AstuteFlamez/robocar/phase_1_powertrain/bom.md

# Phase 1 — Bill of Materials

> Parts **introduced or first used** in Phase 1 (the powertrain + the motor side of the power tree). This is a slice of the master list — see [`../_engineering/products_to_buy.md`](../_engineering/products_to_buy.md) for the full, union-of-all-phases BOM with cost summary. Prices are ballpark USD, early 2026. "Why" gives the *electrical* reason the part exists.

## Core: brain + motor drivers

| Item | Qty | ~$ | Why (electrical reason) | Link | Status |
|---|---|---|---|---|---|
| Raspberry Pi Pico 2W (RP2350) | 1 | — | Real-time co-processor; sources four 20 kHz PWM channels + direction bits. 3V3(OUT) (≤300 mA) feeds the driver logic. Powered from laptop USB this phase. | (have) | already have (kit/shelf) |
| Pololu **TB6612FNG** dual H-bridge (#713) | 2 | $9.90 ($11.45) | 1.2 A continuous / **3.2 A peak per channel** → real headroom over the 310's 1.4 A stall; one motor/channel = 4 independent wheels for Mecanum. Replaces the DRV8833 (whose ~1.2–1.3 A sustainable limit sits on the stall knee). | https://www.pololu.com/product/713 | **buy** |
| "310" metal-gear motors w/ Hall encoders (JGA27-310 / MD310Z20) | 4 | — | The drive wheels: 7.4 V, ≤0.65 A run / **≤1.4 A stall**, 1:20 gearbox. Motor leads used now; encoder conductors parked until Phase 2. | (have) | already have (kit) |
| **JST-PH 2.0 6-pin pigtail leads** | 4 | $8.39 | Mate the motors' *factory* keyed 6-pin plug (motor power + encoder). Keeps a reliable connector instead of 24 mis-wireable bare ends. | [https://www.amazon.com/s?k=jst+ph+2.0+6+pin+pigtail](https://www.amazon.com/10Pair-JST-PH-Connector-Female-Connection/dp/B09JP1YJWL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) | **buy** |

## Power & protection (motor side of the tree)

| Item | Qty | ~$ | Why (electrical reason) | Link | Status |
|---|---|---|---|---|---|
| 2S LiPo 7.4 V 2200 mAh 10C, **w/ built-in protection board** | 1 | — | The single energy source. 10C × 2.2 Ah ≈ 22 A capable — far above the ~5.6 A all-stall motor load. Protection board cuts on overcharge / over-discharge / overcurrent / short. Output = keyed **SM-2P male** plug (mate the SM-2P female pigtail below — *don't cut it*); the keying prevents reverse-mating. Charge via a separate **DC5.5×2.5 barrel** jack with the balance charger. | (have) | already have (kit) |
| **SM-2P female pigtail** (a.k.a. SM2.54 2-pin) | 1 | $4 | Mates the battery's SM-2P male output and breaks it out to red (+) / black (−) leads, then into the WAGO splits. **Don't cut the battery's factory plug.** Keyed → can't mate reversed. | https://www.amazon.com/Connector-VANDESAIL-Female-Adapter-Electrical/dp/B076HLQ4FX | **buy** |
| **WAGO 221-413** lever-nut splice, 3-conductor | 2 | $8.97 | No-solder rail split: one joins LiPo + → both drivers' VM, the other joins LiPo − → both drivers' GND. The **SM-2P pigtail's red/black leads drop straight in** (lift lever, insert, close). ~20 A / 600 V rated — far above the ~5.6 A all-stall load. (A WAGO joins *all* inserted wires — no "in"/"out".) **Mark each WAGO + and −.** | Home Depot (In-Person) | **buy** |
| **Screw Terminal Block: 6-Pin, 0.1″ pitch, side entry** (Pololu #2495) | 2 | $5.42 | One 6-wide block lands each driver's six **power-edge** connections — **AO1, AO2, BO2, BO1, VMOT, GND** (the contiguous positions 3–8 of the power header) — in a single column with one solder operation. The top two power-side pins (**GND, VCC**) sit *outside* the block and instead get a male header for Dupont jumpers to the Pico (3V3 logic + ground). 0.1″ (2.54 mm) pitch, side entry, 150 V / **6 A** (clears the ~2.8 A/driver all-stall load), 26–18 AWG. ⚠️ Side-entry with short pins — meant to be soldered to the board as a standalone module, **not** seated in a breadboard. Sold individually (~$2.71 ea, ~$2.49 ea at qty 5); one block per TB6612FNG, two drivers. | https://www.pololu.com/product/2495 | **buy** |
| **Bulk electrolytic cap, 470–1000 µF, ≥16 V, low-ESR, 105 °C** | 2 | — | One across each driver's **VMOT ↔ GND** (lands in the #2495 block alongside the power wire) to absorb motor start/stall di/dt so the 7.4 V rail doesn't sag. ⚠️ **Polarized — long leg → VMOT, stripe/short leg → GND.** | (have) | already have |
| **0.1 µF (100 nF) ceramic cap** — from a ceramic cap assortment kit (BOJACK, 10 values × ~30 pcs) | 4 (kit has ~30× 0.1 µF + spares) | ~$13 | Brush-noise suppression at the motor outputs. ⚠️ Install is **optional / add-only-if-noisy** — the **connectorized** 310 motors (factory JST-PH 6-pin, no bare tabs) **may already carry a factory cap**, so build without them first; if the USB link drops or (Phase 2) encoder counts jitter, land one **across each channel's AO1↔AO2 / BO1↔BO2 at the driver** (no polarity, no motor surgery). Leaded through-hole MLCCs; the assortment also covers decoupling values reused in later phases. ⚠️ Confirm the 0.1 µF is rated ≥16 V (these kits are typically 50 V). | https://www.amazon.com/BOJACK-Capacitor-Multilayer-Monolithic-Assortment/dp/B085RDTCCV | **buy** |

## Wiring, tools & instrumentation

| Item | Qty | ~$ | Why (electrical reason) | Link | Status |
|---|---|---|---|---|---|
| **18 AWG silicone stranded wire** (red + black, 2-conductor parallel, 5 ft) | 1 | ~$6 | The **7.4 V motor-power loop**: battery → WAGO and WAGO → each driver **VM/GND** (~2.8 A/leg, ~5.6 A all-stall), plus the **motor-return legs**. 18 AWG (~16 A) ≫ the load; silicone = flexible + heat-tolerant. ⚠️ **Power path only — never the kit's thin Dupont jumpers** (those are ~1–2 A, signal-only). Peel the bonded pair apart at the ends to land in the #2495 screw terminals. *(5 ft suits Phases 1–2; the Phase-3 protection chain may want a longer length.)* | https://www.amazon.com/BNTECHGO-Silicone-Flexible-Strands-Stranded/dp/B08PBVM4K5 | **buy** |
| **8-ch 24 MHz USB logic analyzer** (sigrok/PulseView) | 1 | $13 | See the 20 kHz PWM duty change with command — the Measurement Lab for this phase. | https://www.amazon.com/dp/B0BQ7S16H7 | **buy** (recommended) |

> Quantities like "2 of 4" mean this phase uses part of a multi-pack you buy once (the other caps land in later phases). Deferred out of Phase 1: the **coordinated fuse set (10 A main / 7.5 A motor / 5 A Pi)** and **#2815 reverse-polarity master switch** arrive in **Phase 3** (when the Pi becomes a second branch), and the **22 mm NC mushroom e-stop** in the first **mobile** phase — see those BOMs. The **USB-A→micro-USB cable**, **D24V50F5 buck**, **UBEC**, IMU, PCA9685, camera, and lidar adapter are likewise introduced in their own later-phase BOMs.
