AstuteFlamez/robocar/phase_3_teleop/bom.md

# Phase 3 — Bill of Materials

Parts **introduced or first used** in Phase 3 only. This is a slice of the master list — see [`_engineering/products_to_buy.md`](../_engineering/products_to_buy.md) for the full BOM with every phase's parts, links, and prices.

| Item | Qty | ~$ | Why (electrical reason) | Link | Status |
|---|---|---|---|---|---|
| Pololu **D24V50F5** 5 V/5 A buck regulator (#2851) | 1 | $25 | The Pi 5 needs to see **5 V / 5 A** or it caps USB to 600 mA and browns out; a 5 V/3 A bank can't. 6–38 V in (holds 5 V even at a 6.0 V empty pack), 5 V/5 A out, reverse-protect + soft-start. | https://www.pololu.com/product/2851 | **buy** |
| Pololu **#2815** reverse-polarity master switch *(or rocker + #5381)* | 1 | $8 | With a second branch now present, this is the system master ON/OFF **+** reverse-polarity protection in one P-FET part (no diode drop). Deferred out of Phase 1, where the keyed SM-2P sufficed. | https://www.pololu.com/product/2815 | **buy** |
| Inline **ATC/ATO fuse holders + blades**: **10 A main / 7.5 A motor / 5 A Pi** | 3 + asst | $10 | The coordinated set: main at the battery, smaller branch fuses downstream (selectivity). **Slow-blow** on main + motor branch (ride motor inrush); fast-acting OK on the Pi branch. First useful now that there's >1 branch. | https://www.amazon.com/dp/B0DT4NCD5V | **buy** |
| **22 mm latching mushroom e-stop (1× NC)** | 1 | $8 | First floor-driving phase → a fail-safe physical motor kill in series in the motor branch only; **NC** so a broken wire also trips it. Pi/Pico stay alive to log why. | https://www.amazon.com/dp/B00W947PS0 | **buy** |
| **USB‑A → micro‑USB cable**, short (~20 cm), **data-capable** | 1 | $4 | The Pi↔Pico "spinal cord": 5 V to the Pico's VBUS **+** the serial bridge in one cable. Must carry data, not charge-only. | https://www.amazon.com/s?k=usb+a+to+micro+usb+short+data+cable | **buy** |
| **2S 7.4 V LiPo + USB charger kit** (URGENEX 2× 1800 mAh 35C, Deans T-plug) | 1 kit | $27 | **The robot's real battery — replaces the kit's SM-2P LiPo from Phase 3 on.** The full system now draws **~5.4 A cruise / ~10 A worst case** (Pi-buck + motors + servos), over the SM-2P's ~3 A. The **Deans T-plug (~60 A)** clears it; 35C × 1.8 Ah ≈ 63 A capable. **Includes a simple USB charger** (balances + charges to 8.4 V — no balance-charger setup). Two packs → swap for ~40 min total field time. ⚠️ Bare pack, **no protection board** — that job is now covered by the Phase 3 **10 A main fuse** + **#2815 reverse-protect** and the **2S low-voltage alarm** / Phase 4 **INA219** cutoff. | https://urgenexrc.com/products/urgenex-7-4v-rechargeable-lipo-rc-battery-2s-35c-1800mah-with-deans-t-plug-campatibal-with-most-1-10-1-16-scale-rc-cars-trucks-and-7-4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 | **buy** |
| **Deans T-plug female pigtail** (battery → WAGO) | 1 | $3 | Lands the new battery's keyed T-plug output onto red (+) / black (−) leads that drop into the WAGO split — the T-plug analog of the Phase 1–2 **SM-2P pigtail it replaces**. T-plug is polarized (can't reverse-mate). | https://www.amazon.com/s?k=deans+t+plug+female+pigtail+lead | **buy** |

> **Already on the bot (from Phases 1–2), used again here:** Raspberry Pi 5, Pico 2W, 2× TB6612FNG, 4× 310 motors+encoders, the **WAGO 221-413 splices**, bulk + ceramic caps, screw-terminal carrier. No re-purchase. (The kit's 2S LiPo + SM-2P pigtail from Phases 1–2 are **swapped out** here — see the new battery above.)
>
> **New here, deferred out of Phase 1:** the **#2815 master switch**, the **coordinated fuse set (10 A / 7.5 A / 5 A)**, and the **NC e-stop**. Phase 1's single-branch bench build on a self-protected LiPo, wheels-in-air, didn't need them; this two-branch, floor-driving phase does. The Phase 1/2 power path is rebuilt into the full tree with the **new URGENEX battery** (LiPo → **T-plug pigtail** → main fuse → #2815 switch → motor fuse → e-stop → WAGO → VM).
>
> **Retired this phase:** the 5 V/3 A USB power bank leaves the robot — it stays on the shelf as a **bench-only** tethered supply for Pi OS setup. **The kit's 2S LiPo + SM-2P pigtail are also retired** in favor of the higher-current URGENEX pack — the SM-2P's ~3 A can't carry the full ~10 A system load. (Keep the kit pack as a spare / for Phase 1–2 bench reruns.)

**Phase cost (new spend): ~$85** — the **buck ($25)** turns a tethered prototype into a self-contained battery-powered robot; the protection tree (#2815 switch, fuse set, e-stop ≈ $26) is the safety the bot now needs once it leaves the stand; and the **URGENEX battery + USB charger kit ($27) + T-plug pigtail ($3)** is the higher-current power source the full ~10 A system requires once the Pi and servos join the motors.
