AstuteFlamez/robocar/_manufacturer_device/rrc_lite_controller/3. RRCLite Program Analysis/Lesson 10 RRCLite Brushed DC Motor Program Analysis/Lesson 10 RRCLite Brushed DC Motor Program Analysis.pdf

# Lesson 9 RRCLite Brushed DC Motor Program Analysis

## 1. Preface

The DC motors available in the market are mainly divided into two types: brushless motors and brushed motors. This chapter focuses on explaining brushed DC motors. Brushed Motors:

In brushed DC motors, current flows through the armature coil, generating a magnetic field that interacts with the magnetic field of the permanent magnet, causing the motor to rotate. The following diagram illustrates the working

model of a brushed DC motor.

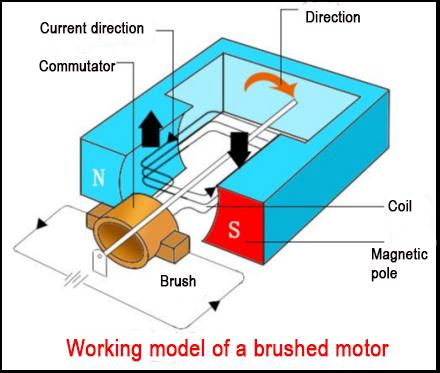
[picture p73: figure]

Components: Permanent magnet, armature coil, brushes, bearings. Speed control principle: By changing the voltage of the power supply, the force on the rotor coil will also change, thereby changing the motor speed. Commutation principle: Changing the direction of current in the coil can

achieve motor commutation.

Brushless Motors:
Working principle: The stator of a brushless DC motor is a coil winding armature, and the rotor is a permanent magnet. The real-time position of the motor rotor is detected, and then different phase currents are applied to the motor according to the rotor position, so that the stator generates a uniformly changing rotational magnetic field, allowing the motor to follow the magnetic field and rotate.
In the previous section, we learned about the principle of brushed DC motors. In this chapter, we will learn about the source code of brushed DC motors. To do this, we need to prepare STM32CubeIDE or Keil5, and a brushed DC

## motor. 2. Program Storage Path

The example routine for this particular content is named "Motor_Demo": Program path: Motor_Demo\motor_porting.c
STM32CubeMX path: Motor_Demo\Motor_Demo.ioc

## 3. Configure the Timer

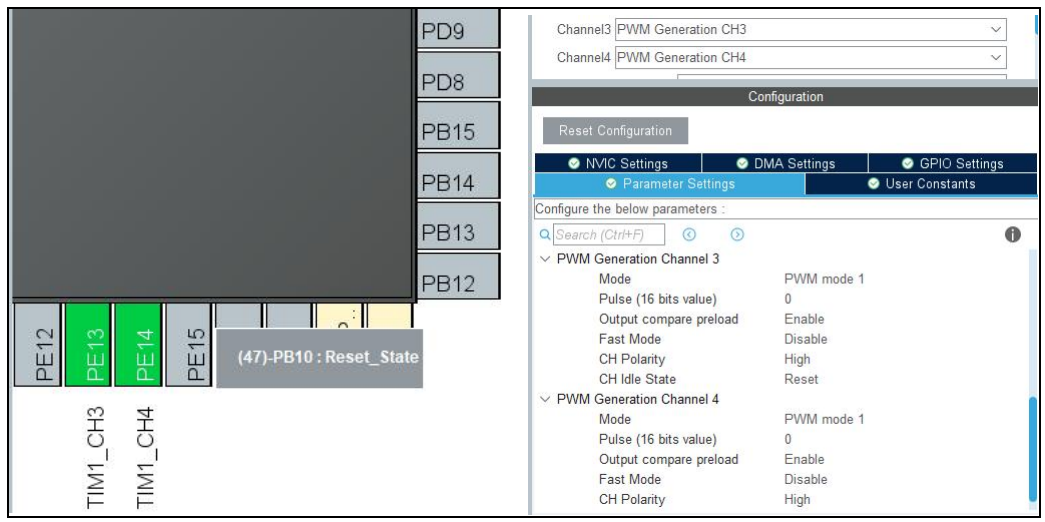
[picture p74: figure]

In STM32CubeIDE, open the STM32CubeMX Configurator. In the Peripherals section, locate TIM1 and enable it. Then, in the Configuration tab, set TIM1 for PWM Generation CH3 and CH4. This will be used for generating PWM signals.

Next, in the STM32CubeMX Configurator, go to TIM1 Configuration. In the PWM Generation Channel 3 and PWM Generation Channel 4 sections, set the appropriate PWM frequency and duty cycle. Click OK to save the settings. Click on Project > Generate Code to generate the initialization code. 4. Clock configuration

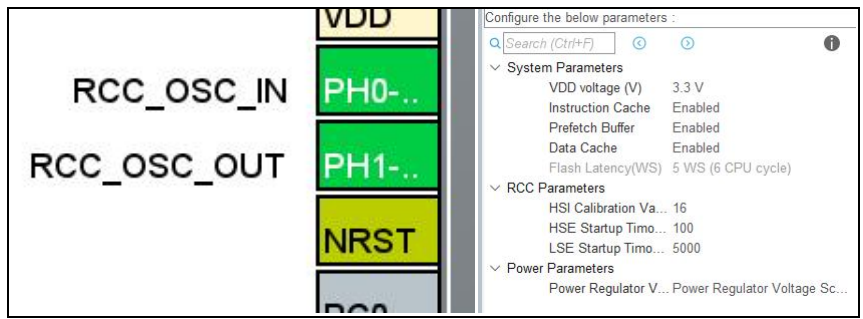
[picture p75: figure]

## 5. Program Analysis

Program Structure Diagram

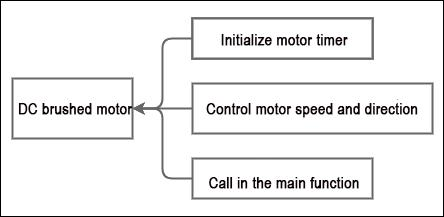
[picture p76: figure]

### 5.1 Initialize Motor Timer

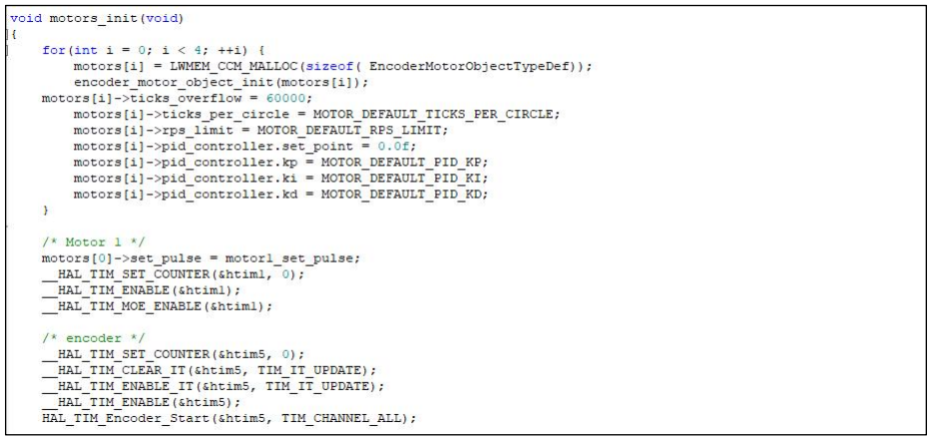
[picture p77: figure]

Note: Every time the motor is used, please make sure that the speed limit, PID, and other parameters used in the motor initialization function match the motor model currently in use. The motor model can be checked in motors_param.h. Reset the counter of the TIM1 timer using the __HAL_TIM_SET_COUNTER()

function. Start the TIM1 timer counting using the __HAL_TIM_ENABLE() function. Enable the Main Output Enable (MOE) of the TIM1 timer to enable PWM signal

output using the __HAL_TIM_MOE_ENABLE() function. 5.2 Control Motor Speed and Direction

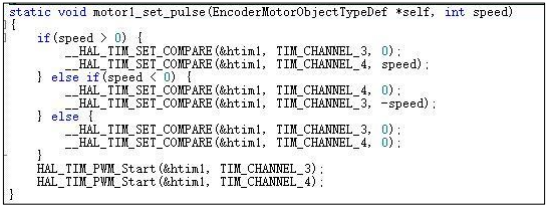
[picture p78: figure]

The function motor1_set_pulse() controls a DC motor by adjusting the duty cycle of the PWM signal, thereby controlling the motor's rotation speed and direction.
If the value of 'speed' is greater than 0, the motor will rotate forward. The function sets the duty cycle of TIM_CHANNEL_3 to 0 and sets the duty cycle of TIM_CHANNEL_4 to 'speed'.
If the value of 'speed' is less than 0, the motor will rotate backward. The function sets the duty cycle of TIM_CHANNEL_4 to 0 and sets the duty cycle of TIM_CHANNEL_3 to the absolute value of 'speed'.
If the value of 'speed' is equal to 0, the motor will stop. The function sets the duty cycle of both TIM_CHANNEL_3 and TIM_CHANNEL_4 to 0. Finally, the function starts the generation of PWM signals on

### TIM_CHANNEL_3 and TIM_CHANNEL_4. 5.3 Call in the app_task_entry Function

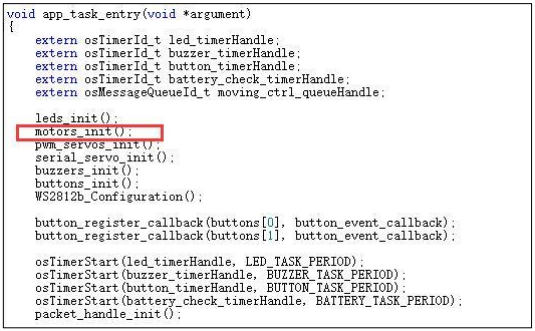
[picture p79: figure]

At the beginning of the task, call the function motors_init() to initialize the motor structure used for controlling the motor.

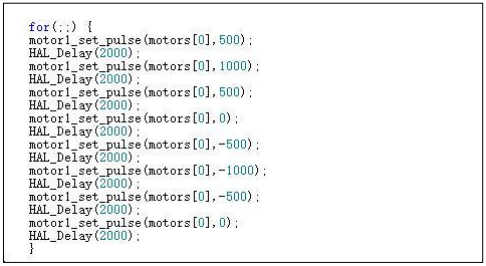
[picture p80: figure]

In the for loop, call the motor1_set_pulse function on the motors[0] motor structure object to change the current PWM duty cycle variable of counter 1. This changes the motor speed.

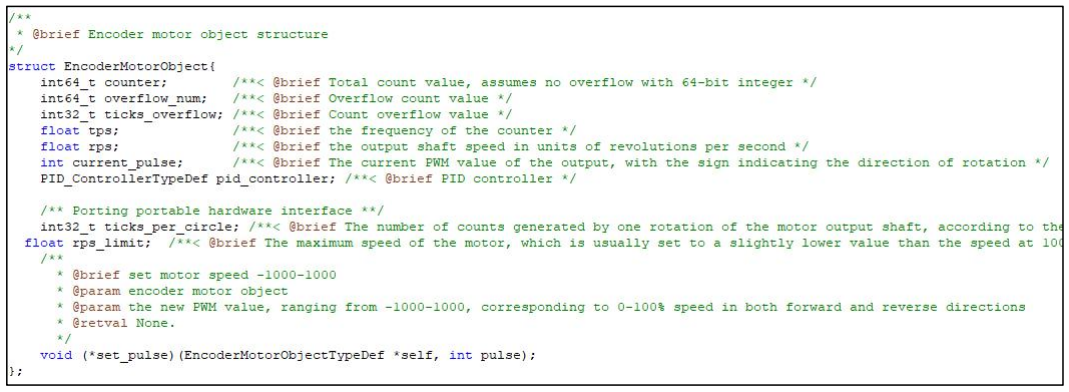
[picture p81: figure]

The above diagram shows the structure of the encoder motor object's structure. For more details, please refer to the comments.
