AstuteFlamez/robocar/_manufacturer_device/rrc_lite_controller/3. RRCLite Program Analysis/Lesson 12 RRCLite DC Brushed Motor PID Control and Source Code Analysis/PID Basic Learning/Lesson 3 Encoder reads cumulative value.pdf

# Position PID Control Basics

Position closed-loop control means that the position information of the motor is measured based on the pulse accumulation of the encoder and compared with the target value to obtain the control deviation. Then the process of controlling the proportional (P), integral (I) and differential (D) of the deviation to make the deviation tend to zero.

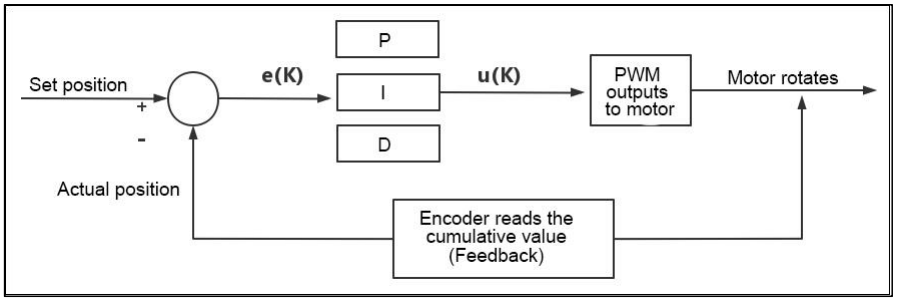
[picture p196: figure]

You can refer to the following formulate:

formula：PWM=Kpe(k)+KiΣe(k)+Kd[e(k)-e(k-1)]

e(k)：current deviation

Σe(k)：deviation accumulation

e(k-1)：previous deviation

Kp： proportionality coefficient

Ki：Integral coefficient

Kd：differential coefficient
