AstuteFlamez/robocar/_manufacturer_device/rrc_lite_controller/_firmware_src/RosRobotControllerLite_ros/Core/Inc/main.h

#define BUZZER_Pin GPIO_PIN_6
#define BUZZER_GPIO_Port GPIOA
#define BATTERY_Pin GPIO_PIN_0
#define BATTERY_GPIO_Port GPIOB
#define TIM1_CH1_Pin GPIO_PIN_9
#define TIM1_CH1_GPIO_Port GPIOE
#define TIM1_CH2_Pin GPIO_PIN_11
#define TIM1_CH2_GPIO_Port GPIOE
#define TIM1_CH3_Pin GPIO_PIN_13
#define TIM1_CH3_GPIO_Port GPIOE
#define TIM1_CH4_Pin GPIO_PIN_14
#define TIM1_CH4_GPIO_Port GPIOE
#define IMU_ITR_Pin GPIO_PIN_12
#define IMU_ITR_GPIO_Port GPIOB
#define IMU_ITR_EXTI_IRQn EXTI15_10_IRQn
#define LED1_Pin GPIO_PIN_9
#define LED1_GPIO_Port GPIOD
#define LED2_Pin GPIO_PIN_10
#define LED2_GPIO_Port GPIOD
#define LED3_Pin GPIO_PIN_11
#define LED3_GPIO_Port GPIOD
#define PWM_SERVO_3_Pin GPIO_PIN_8
#define PWM_SERVO_3_GPIO_Port GPIOC
#define PWM_SERVO_4_Pin GPIO_PIN_9
#define PWM_SERVO_4_GPIO_Port GPIOC
#define BUZZER_OLD_Pin GPIO_PIN_8
#define BUZZER_OLD_GPIO_Port GPIOA
#define DBG_TX_Pin GPIO_PIN_9
#define DBG_TX_GPIO_Port GPIOA
#define DBG_RX_Pin GPIO_PIN_10
#define DBG_RX_GPIO_Port GPIOA
#define PWM_SERVO_1_Pin GPIO_PIN_11
#define PWM_SERVO_1_GPIO_Port GPIOA
#define PWM_SERVO_2_Pin GPIO_PIN_12
#define PWM_SERVO_2_GPIO_Port GPIOA
#define KEY2_Pin GPIO_PIN_0
#define KEY2_GPIO_Port GPIOE
#define KEY1_Pin GPIO_PIN_1
#define KEY1_GPIO_Port GPIOE
