AstuteFlamez/robocar/_manufacturer_device/rrc_lite_controller/_firmware_src/RosRobotControllerLite_ros/Core/Src/main.c

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
/* Includes ------------------------------------------------------------------*/
#include "main.h"
#include "cmsis_os.h"
#include "adc.h"
#include "crc.h"
#include "dma.h"
#include "i2c.h"
#include "spi.h"
#include "tim.h"
#include "usart.h"
#include "gpio.h"

/* USER CODE BEGIN Includes */
#include "lwmem_porting.h"
#include "log.h"
#include <stdio.h>
/* USER CODE END Includes */


void SystemClock_Config(void);
void MX_FREERTOS_Init(void);
static void MX_NVIC_Init(void);
/* USER CODE BEGIN PFP */
void packet_init(void);
void i2c_scan(void)
{
    uint8_t data;
    printf("   ");
    for(int i = 0; i < 0x0F; ++i) {
        printf("0%1X ", i);
    }
    printf("\r\n");
    for(uint8_t i = 0; i < 0x07; ++i) {
        printf("%1X0 ", i);
        for(uint8_t j = 0; j < 0x0F; ++j) {
            uint8_t addr = (i << 4) | j;
            uint8_t re = HAL_I2C_Mem_Read(&hi2c1, addr << 1, 0, I2C_MEMADD_SIZE_8BIT, &data, 1, 0xff);
            if(re == HAL_OK) {
                printf("%02X ", addr);
            } else {
                printf("__ ");
            }
        }
        printf("\r\n");
    }
}
/* USER CODE END PFP */

/* USER CODE BEGIN 0 */
// extern USBH_StatusTypeDef USBH_HID_Joystick_Decode(USBH_HandleTypeDef *phost);
// extern USBH_HandleTypeDef hUsbHostHS;

/* USER CODE END 0 */

/**
  * @brief  The application entry point.
  * @retval int
  */
int main(void)
{
  /* USER CODE BEGIN 1 */
  LOG_INIT();
  SEGGER_RTT_Init();
  lwmem_assignmem(lwmem_regions);  
  /* USER CODE END 1 */

  /* MCU Configuration--------------------------------------------------------*/

  /* Reset of all peripherals, Initializes the Flash interface and the Systick. */
  HAL_Init();

  /* Configure the system clock */
  SystemClock_Config();

  /* USER CODE BEGIN SysInit */
    __HAL_RCC_I2C1_CLK_ENABLE();
	__HAL_RCC_UART5_CLK_ENABLE();
    __HAL_RCC_DMA1_CLK_ENABLE();
  /* USER CODE END SysInit */

  /* Initialize all configured peripherals */
  MX_GPIO_Init();
  MX_DMA_Init();
  MX_USART1_UART_Init();
  MX_TIM1_Init();
  MX_TIM2_Init();
  MX_TIM5_Init();
  MX_TIM9_Init();
  MX_TIM10_Init();
  MX_TIM11_Init();
  MX_I2C2_Init();
  MX_TIM7_Init();
  MX_TIM3_Init();
  MX_TIM4_Init();
  MX_TIM13_Init();
  MX_CRC_Init();
  MX_TIM12_Init();
  MX_ADC1_Init();
  MX_I2C1_Init();
  MX_UART5_Init();
  MX_SPI1_Init();

  /* Initialize interrupts */
  MX_NVIC_Init();
  /* USER CODE BEGIN 2 */
  LOG_DEBUG("Start...\r\n");
  packet_init();
  /* USER CODE END 2 */

  /* Init scheduler */
  osKernelInitialize();  /* Call init function for freertos objects (in freertos.c) */
  MX_FREERTOS_Init();

  /* Start scheduler */
  osKernelStart();
  /* We should never get here as control is now taken by the scheduler */
  /* Infinite loop */
  /* USER CODE BEGIN WHILE */
    while (1) {
    /* USER CODE END WHILE */

    /* USER CODE BEGIN 3 */
    }
  /* USER CODE END 3 */
}

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
/**
  * @brief  Period elapsed callback in non blocking mode
  * @note   This function is called  when TIM14 interrupt took place, inside
  * HAL_TIM_IRQHandler(). It makes a direct call to HAL_IncTick() to increment
  * a global variable "uwTick" used as application time base.
  * @param  htim : TIM handle
  * @retval None
  */
void HAL_TIM_PeriodElapsedCallback(TIM_HandleTypeDef *htim)
{
  if (htim->Instance == TIM14) {
    HAL_IncTick();
  }
}

/**
  * @brief  This function is executed in case of error occurrence.
  * @retval None
  */
void Error_Handler(void)
{
  /* USER CODE BEGIN Error_Handler_Debug */
    /* User can add his own implementation to report the HAL error return state */
    __disable_irq();
    while (1) {
    }
  /* USER CODE END Error_Handler_Debug */
}

#ifdef  USE_FULL_ASSERT
/**
  * @brief  Reports the name of the source file and the source line number
  *         where the assert_param error has occurred.
  * @param  file: pointer to the source file name
  * @param  line: assert_param error line source number
  * @retval None
  */
void assert_failed(uint8_t *file, uint32_t line)
{
  /* USER CODE BEGIN 6 */
    /* User can add his own implementation to report the file name and line number,
       ex: printf("Wrong parameters value: file %s on line %d\r\n", file, line) */
  /* USER CODE END 6 */
}
#endif /* USE_FULL_ASSERT */
