AstuteFlamez/robocar/_manufacturer_device/rrc_lite_controller/_firmware_src/RosRobotControllerLite_ros/Hiwonder/System/packet_handle.c

#include "packet.h"
#include "global.h"
#include "led.h"
#include "buzzer.h"
#include "serial_servo.h"
#include "packet_reports.h"
#include "motors_param.h"

#pragma pack(1)
typedef struct {
    uint8_t cmd;
    uint8_t motor_num;
    struct {
        uint8_t motor_id;
        float speed;
    } element[];
} MotorMutilCtrlCommandTypeDef;

typedef struct {
    uint8_t cmd;
    uint8_t motor_id;
    float speed;
} MotorSingalCtrlCommandTypeDef;

typedef struct {
    uint8_t cmd;
    uint8_t motor_id;
} MotorSingalStopCommandTypeDef;

typedef struct {
    uint8_t cmd;
    uint8_t motor_mask;
} MotorMultiStopCommandTypeDef;

/* 串口舵机 */
typedef struct {
    uint8_t cmd;
    uint8_t servo_id;
    uint8_t args[];
} SerialServoCommandTypeDef;

/* 串口舵机 */
typedef struct {
    uint8_t cmd;
    uint8_t servo_num;
	uint8_t args[];
} SerialServoMultiCommandTypeDef;
/* 串口舵机 */
typedef struct {
    uint8_t cmd;
    uint16_t duration;
    uint8_t servo_num;
    struct {
        uint8_t servo_id;
        uint16_t position;
    } elements[];
} SerialServoSetPositionCommandTypeDef;

/* PWM 舵机 */
typedef struct {
    uint8_t cmd;
    uint8_t servo_id;
    uint8_t args[];
} PWM_ServoCommandTypeDef;

typedef struct {
    uint8_t cmd;
    uint16_t duration;
    uint8_t servo_id;
    uint16_t pulse;
} PWM_ServoSetPositionCommandTypeDef;

typedef struct {
    uint8_t cmd;
    uint16_t duration;
    uint8_t servo_num;
    struct {
        uint8_t servo_id;
        uint16_t pulse;
    } elements[];
} PWMServoSetMultiPositionCommandTypeDef;
/* LED */

typedef struct {
    uint8_t led_id;
    uint16_t on_time;
    uint16_t off_time;
    uint16_t repeat;
} LedCommandTypeDef;


typedef struct {
    uint16_t freq;
    uint16_t on_time;
    uint16_t off_time;
    uint16_t repeat;
} BuzzerCommandTypeDef;


typedef struct {
	uint8_t sub_cmd;
	uint8_t length;
	uint8_t data[];
} OLEDCommandTypeDef;

//电机类型切换
typedef struct {
    uint8_t func;
    uint8_t type;
} MotorTypeCtlTypeDef; 

//电压报警值设置
typedef struct {
    uint8_t cmd;
    uint16_t limit;
} BatteryWarnTypeDef;

//RGB灯结构体
typedef struct {
    uint8_t id;
    uint8_t data[];
} RGBCtlTypeDef;

#pragma pack()

#if ENABLE_OLED
static void packet_oled_handle(struct PacketRawFrame *frame)
{	
	extern osMutexId_t oled_mutexHandle;
	extern char oled_l1[];
	extern char oled_l2[];
	OLEDCommandTypeDef *cmd = (OLEDCommandTypeDef*)frame->data_and_checksum;
	osMutexAcquire(oled_mutexHandle, osWaitForever);
	switch(cmd->sub_cmd) {
		case 0x01: { /* 设置 SSID */
			memcpy(oled_l1, cmd->data, cmd->length);
			oled_l1[cmd->length] = '\0';
			break;
		}
		case 0x02:{ /* 设置 IP 地址 */
			memcpy(oled_l2, cmd->data, cmd->length);
			oled_l2[cmd->length] = '\0';
			break;
		}
		default: {
			break;
		}
	}
	osMutexRelease(oled_mutexHandle);
}
#endif

/**
* @brief 串口命令回调处理
* @param frame 数据帧
* @retval void
*/
static void packet_led_handle(struct PacketRawFrame *frame)
{
    LedCommandTypeDef *cmd = (LedCommandTypeDef*)frame->data_and_checksum;
    uint8_t led_id = cmd->led_id - 1;
    if(led_id < 2) { /* ID 都是从 1 开始 */
        led_flash(leds[led_id], cmd->on_time, cmd->off_time, cmd->repeat);
    }
}

/**
* @brief 串口命令回调处理
* @param frame 数据帧
* @retval void
*/
static void packet_buzzer_handle(struct PacketRawFrame *frame)
{
    BuzzerCommandTypeDef *cmd = (BuzzerCommandTypeDef*)frame->data_and_checksum;
    buzzer_didi(buzzers[0], cmd->freq, cmd->on_time, cmd->off_time, cmd->repeat);
}


static void packet_serial_servo_report_init(PacketReportSerialServoTypeDef * report, uint8_t servo_id, uint8_t cmd, int success)
{
    report->servo_id = servo_id;
    report->sub_command = cmd;
    report->success = (uint8_t)((int8_t)success);
}

static void packet_serial_servo_handle(struct PacketRawFrame *frame)
{
    PacketReportSerialServoTypeDef report;
    switch(frame->data_and_checksum[0]) {
        case 0x01: { /* 舵机控制 */
            SerialServoSetPositionCommandTypeDef *cmd = (SerialServoSetPositionCommandTypeDef *)frame->data_and_checksum;
            for(int i = 0; i < cmd->servo_num; i++) {
                serial_servo_set_position(&serial_servo_controller, cmd->elements[i].servo_id, cmd->elements[i].position, cmd->duration);
            }
            break;
        }
        case 0x03: { /* 停止舵机 */
            SerialServoMultiCommandTypeDef *cmd = (SerialServoMultiCommandTypeDef *)frame->data_and_checksum;
			for(int i = 0; i < cmd->servo_num; i++) {
				serial_servo_stop(&serial_servo_controller, cmd->args[i]);
			}
            break;
        }
        case 0x05: { /* 位置读取 */
            int16_t position = 0;
            SerialServoCommandTypeDef *cmd = (SerialServoCommandTypeDef *)frame->data_and_checksum;
            packet_serial_servo_report_init(&report, cmd->servo_id, cmd->cmd,  serial_servo_read_position(&serial_servo_controller, cmd->servo_id, &position));
            memcpy(report.args, &position, 2);
            packet_transmit(&packet_controller, PACKET_FUNC_BUS_SERVO, &report, 5);
            break;
        }
        case 0x07: { /* 输入电压读取 */
            uint16_t vin = 0;
            SerialServoCommandTypeDef *cmd = (SerialServoCommandTypeDef *)frame->data_and_checksum;
            packet_serial_servo_report_init(&report, cmd->servo_id, cmd->cmd, serial_servo_read_vin(&serial_servo_controller, cmd->servo_id, &vin));
            memcpy(report.args, &vin, 2);
            packet_transmit(&packet_controller, PACKET_FUNC_BUS_SERVO, &report, 5);
            break;
        }
        case 0x09: { /* 温度读取 */
            uint8_t temp = 0;
            SerialServoCommandTypeDef *cmd = (SerialServoCommandTypeDef *)frame->data_and_checksum;
            packet_serial_servo_report_init(&report, cmd->servo_id, cmd->cmd,  serial_servo_read_temp(&serial_servo_controller, cmd->servo_id, &temp));
            report.args[0] = temp;
            packet_transmit(&packet_controller, PACKET_FUNC_BUS_SERVO, &report, 4);
            break;
        }
        case 0x0B: { /* 卸载动力 */
            SerialServoCommandTypeDef *cmd = (SerialServoCommandTypeDef *)frame->data_and_checksum;
            serial_servo_load_unload(&serial_servo_controller, cmd->servo_id, 0);
            break;
        }
        case 0x0C: { /* 加载动力 */
            SerialServoCommandTypeDef *cmd = (SerialServoCommandTypeDef *)frame->data_and_checksum;
            serial_servo_load_unload(&serial_servo_controller, cmd->servo_id, 1);
            break;
        }
		case 0x0D: { /* 动力状态读取 */
            uint8_t load_unload;
            SerialServoCommandTypeDef *cmd = (SerialServoCommandTypeDef *)frame->data_and_checksum;
            packet_serial_servo_report_init(&report, cmd->servo_id, cmd->cmd, serial_servo_read_load_unload(&serial_servo_controller, cmd->servo_id, &load_unload));
            report.args[0] = load_unload;
            packet_transmit(&packet_controller, PACKET_FUNC_BUS_SERVO, &report, 4);
            break;
		}			
        case 0x10: { /* ID 写入 */
            SerialServoCommandTypeDef *cmd = (SerialServoCommandTypeDef *)frame->data_and_checksum;
            serial_servo_set_id(&serial_servo_controller, cmd->servo_id, cmd->args[0]);
            break;
        }
        case 0x12: { /* ID 读取 */
            uint8_t servo_id;
            SerialServoCommandTypeDef *cmd = (SerialServoCommandTypeDef *)frame->data_and_checksum;
            packet_serial_servo_report_init(&report, cmd->servo_id, cmd->cmd, serial_servo_read_id(&serial_servo_controller, cmd->servo_id, &servo_id));
            report.args[0] = servo_id;
            packet_transmit(&packet_controller, PACKET_FUNC_BUS_SERVO, &report, 4);
            break;
        }
        case 0x20: { /* 偏差调整 */
            SerialServoCommandTypeDef *cmd = (SerialServoCommandTypeDef *)frame->data_and_checksum;
            serial_servo_set_deviation(&serial_servo_controller, cmd->servo_id, cmd->args[0]);
            break;
        }
        case 0x22: { /* 偏差读取 */
            int8_t dev = 0;
            SerialServoCommandTypeDef *cmd = (SerialServoCommandTypeDef *)frame->data_and_checksum;
            packet_serial_servo_report_init(&report, cmd->servo_id, cmd->cmd, serial_servo_read_deviation(&serial_servo_controller, cmd->servo_id, &dev));
            report.args[0] = (uint8_t)dev;
            packet_transmit(&packet_controller, PACKET_FUNC_BUS_SERVO, &report, 4);
            break;
        }
        case 0x24: { /* 偏差保存 */
            SerialServoCommandTypeDef *cmd = (SerialServoCommandTypeDef *)frame->data_and_checksum;
            serial_servo_save_deviation(&serial_servo_controller, cmd->servo_id);
            break;
        }
        case 0x30: { /* 位置限制设置 */
            SerialServoCommandTypeDef *cmd = (SerialServoCommandTypeDef *)frame->data_and_checksum;
            serial_servo_set_angle_limit(&serial_servo_controller, cmd->servo_id, *((uint16_t*)(&cmd->args[0])), *((uint16_t*)(&cmd->args[2])));
            break;
        }
        case 0x32: { /* 位置限制读取 */
            uint16_t limit[2] = {0};
            SerialServoCommandTypeDef *cmd = (SerialServoCommandTypeDef *)frame->data_and_checksum;
            packet_serial_servo_report_init(&report, cmd->servo_id, cmd->cmd, serial_servo_read_angle_limit(&serial_servo_controller, cmd->servo_id, limit));
            memcpy(&report.args, limit, 4);
            packet_transmit(&packet_controller, PACKET_FUNC_BUS_SERVO, &report, 7);
            break;
        }
        case 0x34: { /* 电压限制设置 */
            SerialServoCommandTypeDef *cmd = (SerialServoCommandTypeDef *)frame->data_and_checksum;
            serial_servo_set_vin_limit(&serial_servo_controller, cmd->servo_id, *((uint16_t*)(&cmd->args[0])), *((uint16_t*)(&cmd->args[2])));
            break;
        }
        case 0x36: { /* 电压限制读取 */
            uint16_t limit[2] = {0};
            SerialServoCommandTypeDef *cmd = (SerialServoCommandTypeDef *)frame->data_and_checksum;
            packet_serial_servo_report_init(&report, cmd->servo_id, cmd->cmd, serial_servo_read_vin_limit(&serial_servo_controller, cmd->servo_id, limit));
            memcpy(&report.args, limit, 4);
            packet_transmit(&packet_controller, PACKET_FUNC_BUS_SERVO, &report, 7);
            break;
        }
        case 0x38: { /* 温度限制设置 */
            SerialServoCommandTypeDef *cmd = (SerialServoCommandTypeDef *)frame->data_and_checksum;
            serial_servo_set_temp_limit(&serial_servo_controller, cmd->servo_id, cmd->args[0]);
            break;
        }
        case 0x3A: { /* 温度限制读取 */
            uint8_t limit = 0;
            SerialServoCommandTypeDef *cmd = (SerialServoCommandTypeDef *)frame->data_and_checksum;
            packet_serial_servo_report_init(&report, cmd->servo_id, cmd->cmd, serial_servo_read_temp_limit(&serial_servo_controller, cmd->servo_id, &limit));
            report.args[0] = limit;
            packet_transmit(&packet_controller, PACKET_FUNC_BUS_SERVO, &report, 4);
            break;
        }

        default:
            break;
    }
}


/**
* @brief PWM舵机串口命令回调处理
* @param frame 数据帧
* @retval void
*/
static void packet_pwm_servo_handle(struct PacketRawFrame *frame)
{
    switch(frame->data_and_checksum[0]) {
        case 0x01: {    //多个舵机控制
            PWMServoSetMultiPositionCommandTypeDef *cmd = (PWMServoSetMultiPositionCommandTypeDef *)frame->data_and_checksum;
            for(int i = 0; i < cmd->servo_num; ++i) {
                if(cmd->elements[i].servo_id <= 4) {
                    pwm_servo_set_position( pwm_servos[cmd->elements[i].servo_id - 1], cmd->elements[i].pulse, cmd->duration);
                }
            }
            break;
        }
        case 0x03: {    //单个舵机控制
            PWM_ServoSetPositionCommandTypeDef *cmd = (PWM_ServoSetPositionCommandTypeDef *)frame->data_and_checksum;
            //上位机从1号舵机开始
            if(cmd->servo_id <= 4) {
                pwm_servo_set_position( pwm_servos[cmd->servo_id - 1], cmd->pulse, cmd->duration );
            }
            break;
        }
        case 0x05: { // 读取舵机当前位置
            PWM_ServoCommandTypeDef *cmd = (PWM_ServoCommandTypeDef*)frame->data_and_checksum;
            if(cmd->servo_id <= 4) {
                uint16_t pulse = pwm_servos[cmd->servo_id - 1]->current_duty;
                PacketReportPWMServoTypeDef report;
                report.servo_id = cmd->servo_id;
                report.sub_command = cmd->cmd;
                memcpy(report.args, &pulse, 2);
                packet_transmit(&packet_controller, PACKET_FUNC_PWM_SERVO, &report, 4);
            }
            break;
        }
        case 0x07: { // 设置舵机偏差
            PWM_ServoCommandTypeDef *cmd = (PWM_ServoCommandTypeDef*)frame->data_and_checksum;
            if(cmd->servo_id <= 4) {
                pwm_servo_set_offset(pwm_servos[cmd->servo_id - 1], ((int)((int8_t)cmd->args[0])));
            }
            break;
        }
        case 0x09: { // 读取舵机偏差
            PWM_ServoCommandTypeDef *cmd = (PWM_ServoCommandTypeDef*)frame->data_and_checksum;
            if(cmd->servo_id <= 4) {
                int offset = pwm_servos[cmd->servo_id - 1]->offset;
                PacketReportPWMServoTypeDef report;
                report.servo_id = cmd->servo_id;
                report.sub_command = cmd->cmd;
                report.args[0] = (uint8_t)((int8_t)offset);
                packet_transmit(&packet_controller, PACKET_FUNC_PWM_SERVO, &report, 3);
            }
            break;
        }
        default:
            break;
    }
}

/**
* @brief 马达控制串口回调处理
* @param frame 数据帧
* @retval void
*/
static void packet_motor_handle(struct PacketRawFrame *frame)
{

    switch(frame->data_and_checksum[0]) {
        case 0: {
            MotorSingalCtrlCommandTypeDef *mscc = (MotorSingalCtrlCommandTypeDef *)frame->data_and_checksum;
            motors[mscc->motor_id]->pid_controller.set_point = mscc->speed;
            break;
        }
        case 1: {
            MotorMutilCtrlCommandTypeDef *mmcc = NULL;
            mmcc = (MotorMutilCtrlCommandTypeDef *)frame->data_and_checksum;
            for(int i = 0; i < mmcc->motor_num; ++i) {
                motors[mmcc->element[i].motor_id]->pid_controller.set_point = mmcc->element[i].speed;
            }
            break;
        }
        case 2:  {
            MotorSingalStopCommandTypeDef *mssc = (MotorSingalStopCommandTypeDef *)frame->data_and_checksum;
            motors[mssc->motor_id]->pid_controller.set_point = 0;
            break;
        }
        case 3: {
            MotorMultiStopCommandTypeDef *mmsc = (MotorMultiStopCommandTypeDef *)frame->data_and_checksum;
            for(int i = 0; i < 4; ++i) {
                if(mmsc->motor_mask & (0x01 << i)) {
                    motors[i]->pid_controller.set_point = 0;
                }
            }
            break;
        }
        
        case 5: { //电机类型切换
            MotorTypeCtlTypeDef *mmsc = (MotorTypeCtlTypeDef *)frame->data_and_checksum;
            MotorTypeEnum type = MOTOR_TYPE_JGB520;
//            printf("type:%d",mmsc->type);
            if(mmsc->type == MOTOR_TYPE_JGB520){
                type = MOTOR_TYPE_JGB520;
            }else if(mmsc->type == MOTOR_TYPE_JGB37){
                type = MOTOR_TYPE_JGB37;
            }else if(mmsc->type == MOTOR_TYPE_JGA27){
                type = MOTOR_TYPE_JGA27;
            }else if(mmsc->type == MOTOR_TYPE_JGB528){
                type = MOTOR_TYPE_JGB528;
            }else {
                type = MOTOR_TYPE_JGB520;
            }
            for(int i = 0 ; i < 4 ; i++){
                set_motor_type(motors[i], type);
            }
            break;
        }
        default:
            break;
    }
}


/**
* @brief 电池报警设置回调处理
* @param frame 数据帧
* @retval void
*/
static void packet_battery_limit_handle(struct PacketRawFrame *frame)
{
    BatteryWarnTypeDef *cmd = (BatteryWarnTypeDef*)frame->data_and_checksum;
    switch(frame->data_and_checksum[0]) {
        case 1: {
            change_battery_limit(cmd->limit);
        }break;
        default:
            break;
    }
}


/**
* @brief RGB控制
* @param frame 数据帧
* @retval void
*/
static void packet_RGB_Ctl_handle(struct PacketRawFrame *frame)
{
    RGBCtlTypeDef *cmd = (RGBCtlTypeDef*)frame->data_and_checksum;
    switch(cmd->id) {
        case 0: {
//            for(int i = 0 ; i < Pixel_S1_NUM ; i++)
//            {
//                set_id_rgb_color(i , &cmd->data[i*3]);
//            }
            set_rgb_color(cmd->data);
        }break;
        
        case 1: 
        case 2: {
            set_id_rgb_color((cmd->id-1) , cmd->data);
        }break;
        
        default:
            break;
    }
}


void packet_handle_init(void)
{
    packet_register_callback(&packet_controller, PACKET_FUNC_LED, packet_led_handle);
    packet_register_callback(&packet_controller, PACKET_FUNC_BUZZER, packet_buzzer_handle);
    packet_register_callback(&packet_controller, PACKET_FUNC_MOTOR, packet_motor_handle);
    packet_register_callback(&packet_controller, PACKET_FUNC_BUS_SERVO, packet_serial_servo_handle);
    packet_register_callback(&packet_controller, PACKET_FUNC_PWM_SERVO, packet_pwm_servo_handle);
    packet_register_callback(&packet_controller, PACKET_FUNC_SYS, packet_battery_limit_handle);
    packet_register_callback(&packet_controller, PACKET_FUNC_RGB, packet_RGB_Ctl_handle);
#if ENABLE_OLED
	packet_register_callback(&packet_controller, PACKET_FUNC_OLED, packet_oled_handle);
#endif
}
