AstuteFlamez/robocar/(commit log)

2026-05-28 Initial commit: 4WD autonomous robot car build plan
    8-phase project plan covering motors, odometry, WiFi teleop, IMU,
    camera + pan/tilt, lidar (STL-19P), SLAM, and autonomous navigation.
    Architecture: Pi 5 + Pico 2W co-processor, talking over USB.
    Each phase doc contains ASCII schematics, line-by-line wire lists,
    pin tables, software tasks, verification checklist, and pitfalls.
2026-05-29 Reorganize into per-phase folders + _engineering source-of-truth, reconciled to the actual MentorPi M1
    Identified the kit as a Hiwonder MentorPi M1 (Mecanum chassis, RRC Lite
    controller, 310 encoder motors, STL-19P lidar, depth camera, LFD-01 servos,
    2S LiPo) and reworked the build plan around the real hardware, verified
    against datasheets and three adversarial electrical checks.
    New structure
    - _engineering/: device_contracts (per-part V/I/logic/connector + canonical
    pin map + end-to-end connection matrix), products_to_buy (BOM w/ links),
    power_budget (power tree + current budget + sizing), engineering_decisions
    (ADR-style rationale), safety, and an index README.
    - phase_1..8/: each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
2026-05-29 Add CLAUDE.md — working guide for agents improving the docs
    Captures the source-of-truth hierarchy (_engineering/ first, then ripple),
    the golden rules (canonical pin map, canonical FL,RL,FR,RR wheel order,
    Mecanum-not-differential, datasheet-verify), the verified key facts, the
    style/quality bar, a recommended review workflow with consistency greps,
    and the open items only the human can close.
2026-05-29 Add _manufacturer_device vendor reference (read-only input)
    As-shipped Hiwonder MentorPi M1 reference: whole-robot hardware/device map,
    manufacturer robot PDFs, and the RRC Lite controller docs + firmware — the
    ROS2 controller board this project deliberately replaces. Registered in
    CLAUDE.md as read-only input to verify against, not a source of truth.
    [Lesson 1 Depth Camera Configuration.txt]
2026-05-29 Borrow controller-board improvements from the vendor reference
    Mined the working vendor RRC Lite firmware/schematic (read-only oracle) for
    electrically-validated, premise-neutral improvements to robocar's Pico-2W
    controller board — without abandoning its two-brain / bypass-the-vendor design.
    Electrical (working-car-validated):
    - Encoder: confirm 3.3-5V datasheet rating, keep 3.3V (in-spec + RP2350-safe),
    add optional 4.7k A/B pull-ups to 3.3V + scope-edge bench check.
    - Document the deliberate 20kHz-vs-vendor-200Hz PWM divergence + bench check.
    - Specify slow-blow fuses on the main/motor branches for motor inrush.
    - Clarify the master-switch (#2815 8A vs #5381 12A) transient margin.
    Fi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
2026-05-29 Fix incorrect BOM links and reconcile part descriptions across phases
    Verified every BOM hyperlink against vendor pages (web fetch + adversarial
    re-check) and reconciled descriptions to _engineering/device_contracts.md.
    Corrected links (pointed to the wrong/renamed/dead product):
    - MG90S servo: Adafruit #1143 is now the digital MG90D -> generic MG90S source
    - STEMMA-QT hub: Adafruit #4209 is a JST-SH cable, not a hub -> #5625 5-port hub
    - Bulk electrolytic cap: Adafruit #4267 is the I2CDriver tool, not a cap, and no
    Adafruit SKU meets 470-1000uF/>=16V -> DigiKey aluminum-electrolytic filter
    - Cable-tie mounts/VHB: Adafruit #4248 is the NeTV2 dev board -> generic search
    - Ferrule crimper: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
2026-05-29 Correct Pololu #2815 current rating (~8 A -> ~16 A)
    Pololu #2815 is the "Big MOSFET Slide Switch with Reverse Voltage
    Protection, HP", rated ~16 A (4.5-40 V) per the product page — not the
    ~8 A the docs stated. The ~8 A part is the MP sibling, #2814.
    Fixes the rating in device_contracts.md and engineering_decisions.md, and
    the recommendations the wrong figure had inverted: at ~16 A, #2815 alone
    already clears the 10 A main fuse with margin (more than the 12 A #5381),
    so the rocker + #5381 is now framed purely as the "separate master switch"
    option, not a current-headroom upgrade.
2026-05-29 Update JST-PH pigtail leads link in BOM
2026-05-29 Update price for JST-PH 2.0 6-pin pigtail leads
    Updated the price of JST-PH 2.0 6-pin pigtail leads from $6 to $8.39 while maintaining the same description and link.
2026-05-30 Rework Phase 1 power path to real SM-2P/WAGO hardware; stage protection tree to Phase 3
    The kit LiPo is a self-protected pack with a keyed SM-2P output + DC5.5x2.5
    charge jack, not an XT60. Rebuild Phase 1's motor power around the real parts
    and defer the protection chain to where it pays off.
    Phase 1 (& 2, still wheels-on-stand, single branch):
    - SM-2P female pigtail -> 2x WAGO 221-413 splits -> soldered 2.54mm screw
    terminals on each driver. No external fuse, master switch, or e-stop:
    the pack's built-in protection board plus unplug/`stop`/STBY-low suffice.
    - Drop XT60, #2815 switch, coordinated fuses, and NC e-stop from the BOM;
    keep their concepts as deferred/educational with the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
2026-05-30 Modify PCB screw-terminal blocks entry in BOM
    Updated the quantity and price of PCB screw-terminal blocks in the BOM.
2026-05-30 Update BOM with additional details and links
    Updated the BOM to include a link for the PCB screw-terminal blocks and clarified their usage.
2026-05-30 Update BOM with detailed component descriptions
2026-05-30 Update BOM by removing unnecessary wiring items
    Removed several items from the BOM related to wiring and tools, including silicone stranded wire, ferrule kit, jumper wires, breadboard, heat-shrink tubing, and digital multimeter.
2026-05-30 Revise BOM with updated WAGO splice details
    Updated the price and source information for WAGO 221-413 lever-nut splice and removed optional components.
2026-05-30 Phase 1-3: battery uses pre-crimped ferruled leads, drop SM-2P connector
    The actual kit pack's output is two flying leads (red +, black -) in
    crimped ferrules, not a keyed SM-2P plug. Convert the power-path docs to
    match: ferruled leads drop straight into the WAGO splits, with polarity
    metered by hand each power-up since bare leads aren't keyed.
    - phase_1 bom: battery row now "pre-crimped ferrules, unkeyed"; WAGO row
    notes leads drop straight in (kept remote's $8.97 / #2491 pricing)
    - phase_1/2/3 README + wiring diagrams: SM-2P -> ferruled-leads power path
    - phase_3 bom: drop two SM-2P stragglers in the carry-over notes
    Scoped to phases 1-3 per request; _engineering/ and phases 4-8 still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
2026-05-30 Phase 1: restore keyed SM-2P power path, swap to #2495 6-pin terminal, drop standoff
    Per request, reverse the earlier ferruled-leads detour and re-spec the driver
    power-edge termination on the Phase 1 / master BOMs (Phase 1 only for the
    non-BOM docs).
    - phase_1 bom: drop the 0.1in 2P/3P/4P screw-terminal block (#2491) and add the
    Pololu #2495 6-pin side-entry block (x2, one per TB6612FNG) -- it lands the six
    power-edge pins AO1/AO2/BO2/BO1/VMOT/GND at #713 power-header positions 3-8,
    leaving GND/VCC (positions 1-2) for the Pico 3V3 logic + ground header. Restore
    the SM-2P female pigtail row (VANDESAIL B076HLQ4FX). Remove the M2.5 nylon
    standoff kit. Revert the battery + WAGO rows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
2026-05-31 Phase 1: reframe 0.1 uF motor cap as optional (connectorized motors), list both caps as on-hand
    The kit's 310 motors are connectorized (factory JST-PH 6-pin) -- there are no
    bare motor tabs to solder a brush-noise cap across, and these encoder motors
    often already carry a factory cap on the rear board. The RRC Lite vendor docs /
    product page don't expose whether a cap sits at the motor connector, and the
    motors can't be opened to check. So the at-the-motor 0.1 uF is reframed as
    optional / add-only-if-noisy, placed at the driver outputs if needed -- no motor
    surgery, no cutting the factory plug. The bulk cap (rail-sag, at the driver) is
    unchanged and still installed up front.
    - phase_1 bom: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
2026-05-31 Phase 1 bom: ceramic caps are a buy (BOJACK assortment kit), not on-hand
    Correction: the 0.1 uF ceramic caps are NOT already owned. Pololu's two 0.1 uF
    parts (#1166, #2451) are both discontinued, so source from a BOJACK ceramic
    assortment kit on Amazon (10 values x ~30 pcs) -- supplies the 4 needed plus
    spares, and a range of decoupling values reused in later phases. Status flipped
    to buy; install still optional/add-if-noisy at the driver outputs. Bulk cap
    remains already-have.
2026-05-31 Reconcile phases 2-3 + master standoff with the SM-2P power path
    Phase 1 was reverted to the keyed SM-2P output earlier, but the ferrule
    conversion (a6caf5e) had also rewritten phases 2-3 and left the master-list
    standoff tagged Phase 1. Bring the rest in line:
    - phase_2 README + wiring_diagram, phase_3 README + bom + wiring_diagram:
    revert the ferruled-leads wording back to the keyed SM-2P -> pigtail -> WAGO
    path (restored to pre-a6caf5e state). The battery-ferrule story is now gone
    repo-wide; SM-2P is consistent across all phases + _engineering/.
    - products_to_buy.md: re-tag the M2.5 standoff kit from Phase 1 -> Phase 3
    (board mounting begins with the Pi in Phase 3; not used in th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
2026-05-31 Swap battery to URGENEX + Deans T-plug from Phase 3 (full-system ~10A > SM-2P's ~3A)
    The kit's SM-2P pack (~3 A connector) is fine for the Phases 1-2 motors-only
    bench load (~2.6 A), but the finished robot draws ~5.4 A cruise / ~10 A worst
    once the Pi-buck and servos join the motors. So from Phase 3 the battery is
    swapped to the URGENEX 2S 1800mAh 35C pack on a ~60 A Deans T-plug (mated by a
    T-plug pigtail into the WAGO), with an included USB charger. Phases 1-2 keep the
    kit LiPo + SM-2P unchanged.
    Source-of-truth first, then ripple (phases 1-2 untouched):
    - _engineering/device_contracts.md: battery contract now staged (kit SM-2P pack
    Ph1-2 / URGENEX T-plug Ph3+); connection matrix + conn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
2026-05-31 Phase 1 bom: add 18 AWG silicone wire for the motor-power loop
    The WAGO→VM/GND legs and motor-return legs carry ~2.8 A/leg (~5.6 A all-stall) —
    far past the kit's ~1-2 A Dupont jumpers. Add 18 AWG (~16 A) silicone stranded
    wire (BNTECHGO, red+black parallel, 5 ft) as the power-path conductor; jumpers
    stay signal-only. BOM row only (not the wiring diagram, per request).
